royconejo/cese-pcb/README.md

Pagina oficial del proyecto: http://www.retro-ciaa.com

# RETRO-CIAA 
RETRO-CIAA es una expansión para la placa EDU-CIAA-NXP desarrollada por Santiago Germino (royconejo) como trabajo final de la carrera de especializacion en sistemas embebidos de la FI-UBA.

Esta expansión permite sumar nuevas posibilidades a la placa original:

  - Salida de video 720p@60 Hz, resolucion lógica de 256×144 pixels.
  - Audio stereo en 16 bits, 44100 kHz.
  - Conectividad WiFi / Bluetooth.
  - Entrada para dos joysticks de “family game“.

Todo esto sin bloquear la conectividad a los puertos preexistentes.

El proyecto se divide en dos; el hardware (placa de expansión con sus puertos) y un nuevo firmware. Todo sera de diseño y código abierto. El objetivo es aportar herramientas para la enseñanza de computación gráfica o desarrollo de videojuegos.
