royconejo/cese-pcb/retro-ciaa.kicad_pcb

## KiCad design retro-ciaa.kicad_pcb (2018-10-18)

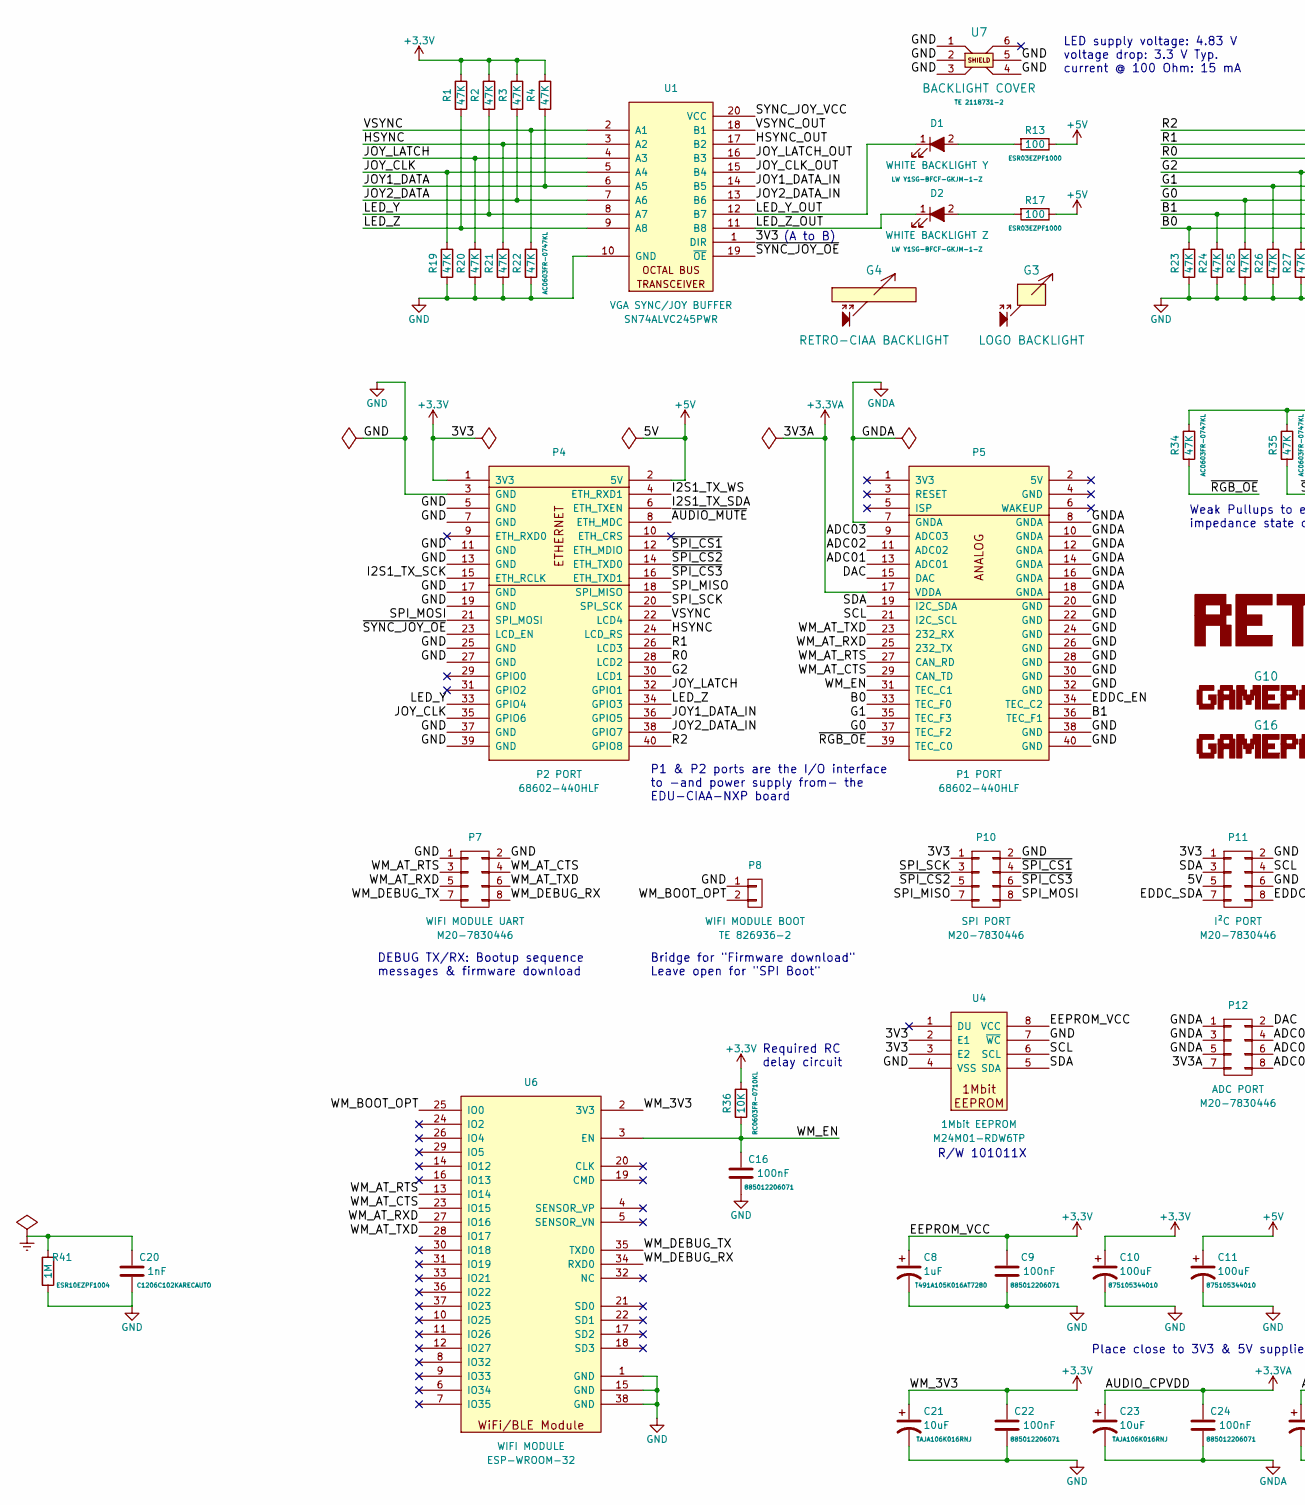
[picture p9: schematic retro-ciaa.sch, part in row 1, column 1]

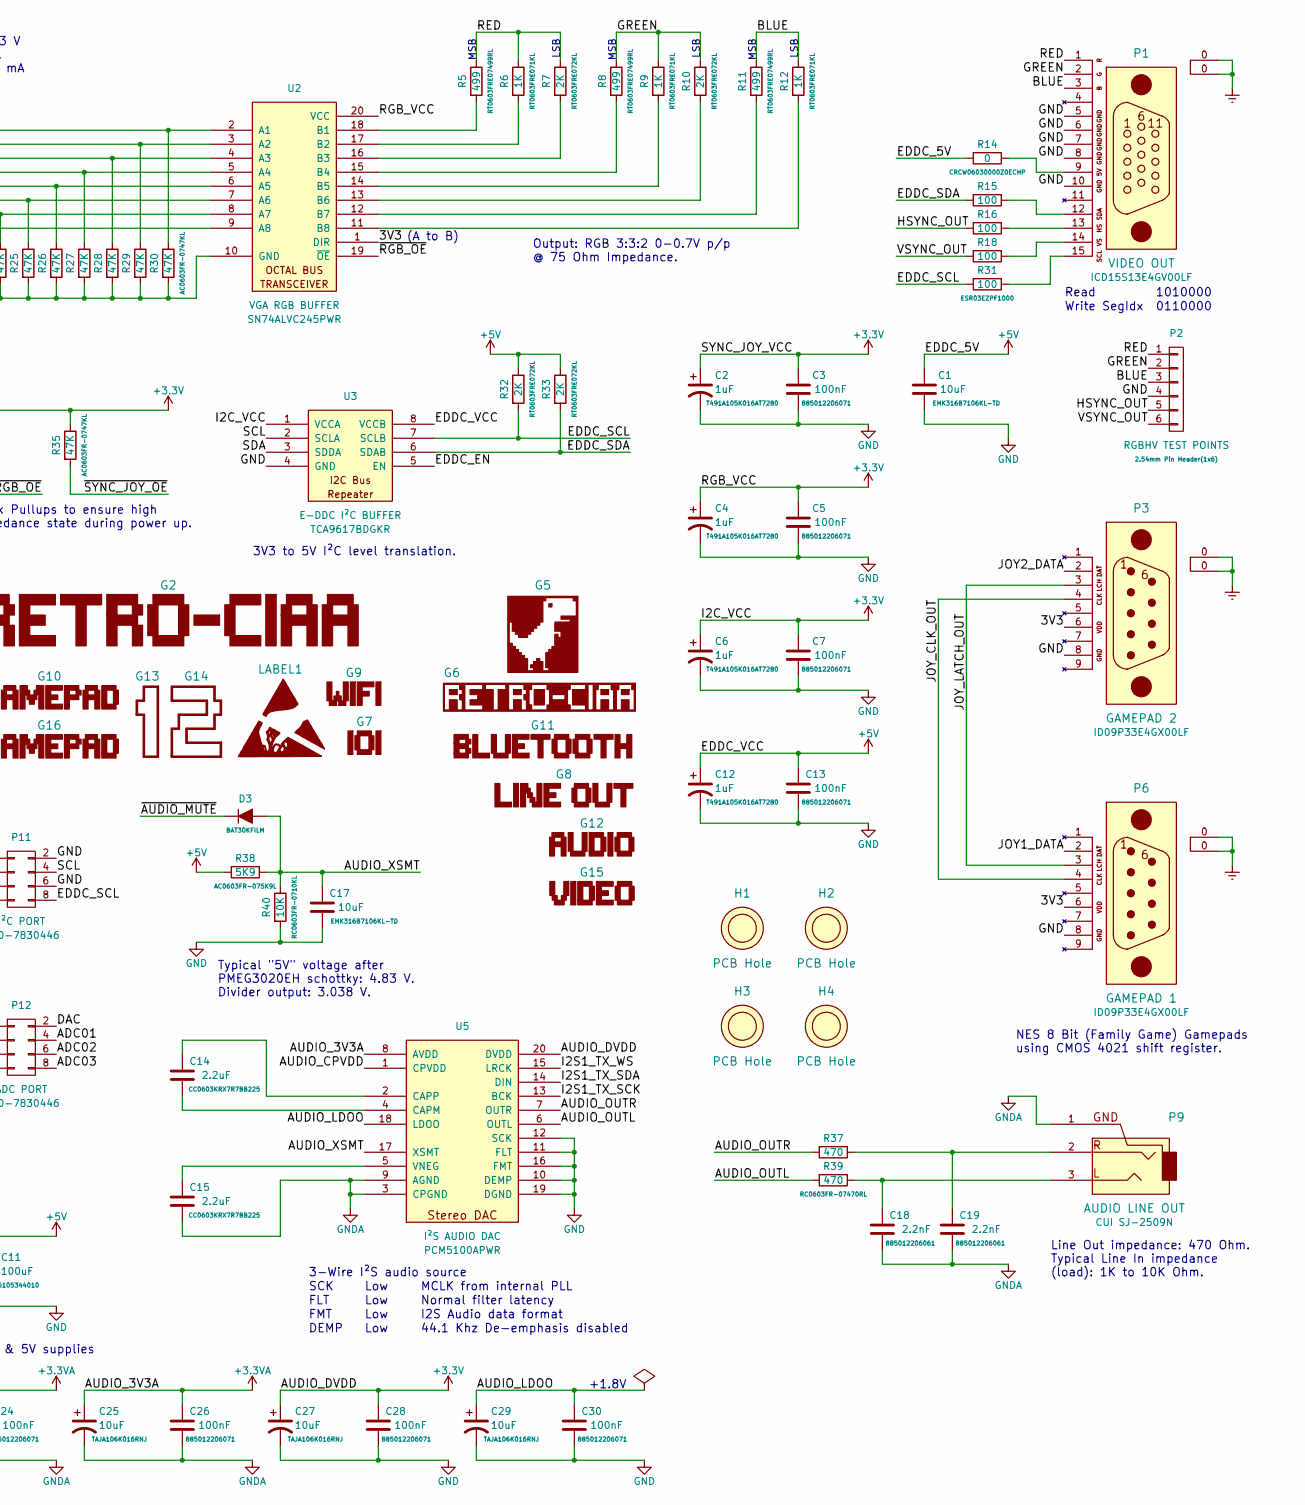
[picture p10: schematic retro-ciaa.sch, part in row 1, column 2]

Parts:
C1, C17: 10uF; C_1206
C2, C4, C6, C8, C12: 1uF; CP_Tantalum_Case-A_EIA-3216-18_Reflow
C3, C5, C7, C9, C13, C16, C22, C24, C26, C28, C30: 100nF; C_0603
C10, C11: 100uF; CP_Elec_6.3x5.8
C14, C15: 2.2uF; C_0603
C18, C19: 2.2nF; C_0603
C20: 1nF; C_1206
C21, C23, C25, C27, C29: 10uF; CP_Tantalum_Case-A_EIA-3216-18_Reflow
D1: WHITE BACKLIGHT Y; LED_LW_Y1SG
D2: WHITE BACKLIGHT Z; LED_LW_Y1SG
D3: BAT30; D_SOD-523
G2: RETROCIAA_LOGO
G3: LOGO BACKLIGHT; TREX_LOGO_BACK
G4: RETRO-CIAA BACKLIGHT; RETROCIAA_LOGO_BACK
G5: LOGO_FRONT; TREX_LOGO_FRONT
G6: RETROCIAA_LOGO_FRONT
G7: RETROCIAA_VIDEO_CONN
G8: RETROCIAA_LINEOUT
G9: RETROCIAA_WIFI
G10, G16: RETROCIAA_GAMEPAD
G11: RETROCIAA_BLUETOOTH
G12: RETROCIAA_AUDIO
G13: RETROCIAA_1
G14: RETROCIAA_2
G15: RETROCIAA_VIDEO
H1, H2, H3, H4: PCB Hole; MountingHole_3.7mm_Pad_Via
LABEL1: ESD_LOGO_15; ESD_Sign_12
P1: VIDEO OUT; DSUB-15-HD_Female_Horizontal_Pitch2.29x1.98mm_EdgePinOffset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
P2: RGBHV TEST POINTS; Pin_Header_Straight_1x06_Pitch2.54mm
P3: GAMEPAD 2; DSUB-9_Male_Horizontal_Pitch2.77x2.84mm_EdgePinOffset7.70mm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
P4: P2 PORT; Pin_Header_Back_2x20_Pitch2.54mm
P5: P1 PORT; Pin_Header_Back_2x20_Pitch2.54mm
P6: GAMEPAD 1; DSUB-9_Male_Horizontal_Pitch2.77x2.84mm_EdgePinOffset7.70mm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
P7: WIFI MODULE UART; Pin_Header_Straight_2x04_Pitch2.54mm
P8: WIFI MODULE BOOT; Pin_Header_Straight_1x02_Pitch2.54mm
P9: AUDIO LINE OUT; CUI_SJ-2509N
P10: SPI PORT; Pin_Header_Straight_2x04_Pitch2.54mm
P11: I²C PORT; Pin_Header_Straight_2x04_Pitch2.54mm
P12: ADC PORT; Pin_Header_Straight_2x04_Pitch2.54mm
R1, R2, R3, R4, R19, R20, R21, R22, R23, R24, R25, R26, R27, R28, R29, R30, R34, R35: 47K; R_0603
R5, R8, R11: 499; R_0603
R6, R9, R12: 1K; R_0603
R7, R10, R32, R33: 2K; R_0603
R13, R15, R16, R17, R18, R31: 100; R_0603
R14: 0; R_0603
R36, R40: 10K; R_0603
R37, R39: 470; R_0603
R38: 5K9; R_0603
R41: 1M; R_0805
U1: VGA SYNC/JOY BUFFER; TSSOP-20_4.4x6.5mm_Pitch0.65mm
U2: VGA RGB BUFFER; TSSOP-20_4.4x6.5mm_Pitch0.65mm
U3: E-DDC I²C BUFFER; VSSOP-8_3.0x3.0mm_Pitch0.65mm
U4: 1Mbit EEPROM; TSSOP-8_4.4x3mm_Pitch0.65mm
U5: I²S AUDIO DAC; TSSOP-20_4.4x6.5mm_Pitch0.65mm
U6: WIFI MODULE; ESP-WROOM-32
U7: BACKLIGHT COVER; TE_SHIELD_2118731-2

Connections:
+3.3VA: C23.1, C24.2, C25.1, C26.2, P5.17 (VDDA), P12.7, U5.1 (CPVDD), U5.8 (AVDD)
+3V3: C2.1, C3.2, C4.1, C5.2, C6.1, C7.2, C8.1, C9.2, C10.1, C21.1, C22.2, C27.1, C28.2, P3.6, P4.1 (3V3), P6.6, P10.1, P11.1, R1.1, R2.1, R3.1, R4.1, R34.1, R35.1, R36.1, U1.1 (DIR), U1.20 (VCC), U2.1 (DIR), U2.20 (VCC), U3.1 (VCCA), U4.2 (E1), U4.3 (E2), U4.8 (VCC), U5.20 (DVDD), U6.2 (3V3)
+5V: C1.2, C11.1, C12.1, C13.2, P4.2 (5V), P11.5, R13.1, R14.2, R17.1, R32.1, R33.1, R38.2, U3.8 (VCCB)
/ADC01: P5.13 (ADC01), P12.4
/ADC02: P5.11 (ADC02), P12.6
/ADC03: P5.9 (ADC03), P12.8
/AUDIO_LDOO: C29.1, C30.2, U5.18 (LDOO)
/AUDIO_OUTL: R39.2, U5.6 (OUTL)
/AUDIO_OUTR: R37.2, U5.7 (OUTR)
/AUDIO_XSMT: C17.2, D3.2 (A), R38.1, R40.1, U5.17 (XSMT)
/B0: P5.33 (TEC_F0), R23.1, U2.9 (A8)
/B1: P5.36 (TEC_F1), R24.1, U2.8 (A7)
/BLUE: P1.3, P2.3, R11.1, R12.1
/DAC: P5.15 (DAC), P12.2
/EDDC_EN: P5.34 (TEC_C2), U3.5 (EN)
/EDDC_SCL: P11.8, R31.2, R32.2, U3.7 (SCLB)
/EDDC_SDA: P11.7, R15.2, R33.2, U3.6 (SDAB)
/G0: P5.37 (TEC_F2), R25.1, U2.7 (A6)
/G1: P5.35 (TEC_F3), R26.1, U2.6 (A5)
/G2: P4.30 (LCD1), R27.1, U2.5 (A4)
/GREEN: P1.2, P2.2, R8.1, R9.1, R10.1
/HSYNC: P4.24 (LCD_RS), R21.1, U1.3 (A2)
/HSYNC_OUT: P2.5, R16.2, U1.17 (B2)
/I2S1_TX_SCK: P4.15 (ETH_RCLK), U5.13 (BCK)
/I2S1_TX_SDA: P4.6 (ETH_TXEN), U5.14 (DIN)
/I2S1_TX_WS: P4.4 (ETH_RXD1), U5.15 (LRCK)
/JOY1_DATA: P6.2, R4.2, U1.6 (A5)
/JOY1_DATA_IN: P4.36 (GPIO5), U1.14 (B5)
/JOY2_DATA: P3.2, R3.2, U1.7 (A6)
/JOY2_DATA_IN: P4.38 (GPIO7), U1.13 (B6)
/JOY_CLK: P4.35 (GPIO6), R19.1, U1.5 (A4)
/JOY_CLK_OUT: P3.4, P6.4, U1.15 (B4)
/JOY_LATCH: P4.32 (GPIO1), R20.1, U1.4 (A3)
/JOY_LATCH_OUT: P3.3, P6.3, U1.16 (B3)
/LED_Y: P4.33 (GPIO4), R2.2, U1.8 (A7)
/LED_Y_OUT: D1.1 (K), U1.12 (B7)
/LED_Z: P4.34 (GPIO3), R1.2, U1.9 (A8)
/LED_Z_OUT: D2.1 (K), U1.11 (B8)
/R0: P4.28 (LCD2), R28.1, U2.4 (A3)
/R1: P4.26 (LCD3), R29.1, U2.3 (A2)
/R2: P4.40 (GPIO8), R30.1, U2.2 (A1)
/RED: P1.1, P2.1, R5.1, R6.1, R7.1
/SCL: P5.21 (I2C_SCL), P11.4, U3.2 (SCLA), U4.6 (SCL)
/SDA: P5.19 (I2C_SDA), P11.3, U3.3 (SDDA), U4.5 (SDA)
/SPI_MISO: P4.18 (SPI_MISO), P10.7
/SPI_MOSI: P4.21 (SPI_MOSI), P10.8
/SPI_SCK: P4.20 (SPI_SCK), P10.3
/VSYNC: P4.22 (LCD4), R22.1, U1.2 (A1)
/VSYNC_OUT: P2.6, R18.2, U1.18 (B1)
/WM_AT_CTS: P5.29 (CAN_TD), P7.4, U6.23 (IO15)
/WM_AT_RTS: P5.27 (CAN_RD), P7.3, U6.13 (IO14)
/WM_AT_RXD: P5.25 (232_TX), P7.5, U6.27 (IO16)
/WM_AT_TXD: P5.23 (232_RX), P7.6, U6.28 (IO17)
/WM_BOOT_OPT: P8.2, U6.25 (IO0)
/WM_DEBUG_RX: P7.8, U6.34 (RXD0)
/WM_DEBUG_TX: P7.7, U6.35 (TXD0)
/WM_EN: C16.2, P5.31 (TEC_C1), R36.2, U6.3 (EN)
/~AUDIO_MUTE: D3.1 (K), P4.8 (ETH_MDC)
/~RGB_OE: P5.39 (TEC_C0), R34.2, U2.19 (~OE)
/~SPI_CS1: P4.12 (ETH_MDIO), P10.4
/~SPI_CS2: P4.14 (ETH_TXD0), P10.5
/~SPI_CS3: P4.16 (ETH_TXD1), P10.6
/~SYNC_JOY_OE: P4.23 (LCD_EN), R35.2, U1.19 (~OE)
Earth: C20.2, P1.0, P3.0, P6.0, R41.1
GND: C1.1, C2.2, C3.1, C4.2, C5.1, C6.2, C7.1, C8.2, C9.1, C10.2, C11.2, C12.2, C13.1, C16.1, C17.1, C20.1, C21.2, C22.1, C27.2, C28.1, C29.2, C30.1, P1.5, P1.6, P1.7, P1.8, P1.10, P2.4, P3.8, P4.3 (GND), P4.5 (GND), P4.7 (GND), P4.11 (GND), P4.13 (GND), P4.17 (GND), P4.19 (GND), P4.25 (GND), P4.27 (GND), P4.37 (GND), P4.39 (GND), P5.20 (GND), P5.22 (GND), P5.24 (GND), P5.26 (GND), P5.28 (GND), P5.30 (GND), P5.32 (GND), P5.38 (GND), P5.40 (GND), P6.8, P7.1, P7.2, P8.1, P10.2, P11.2, P11.6, R19.2, R20.2, R21.2, R22.2, R23.2, R24.2, R25.2, R26.2, R27.2, R28.2, R29.2, R30.2, R40.2, R41.2, U1.10 (GND), U2.10 (GND), U3.4 (GND), U4.4 (VSS), U4.7 (~WC), U5.10 (DEMP), U5.11 (FLT), U5.12 (SCK), U5.16 (FMT), U5.19 (DGND), U6.1 (GND), U6.15 (GND), U6.38 (GND), U7.1, U7.2, U7.3, U7.4, U7.5
GNDA: C15.1, C18.1, C19.1, C23.2, C24.1, C25.2, C26.1, P5.7 (GNDA), P5.8 (GNDA), P5.10 (GNDA), P5.12 (GNDA), P5.14 (GNDA), P5.16 (GNDA), P5.18 (GNDA), P9.1, P12.1, P12.3, P12.5, U5.3 (CPGND), U5.9 (AGND)
unnamed: C14.1, U5.4 (CAPM)
unnamed: C14.2, U5.2 (CAPP)
unnamed: C15.2, U5.5 (VNEG)
unnamed: C18.2, P9.3, R39.1
unnamed: C19.2, P9.2, R37.1
unnamed: D1.2 (A), R13.2
unnamed: D2.2 (A), R17.2
unnamed: P1.9, R14.1
unnamed: P1.12, R15.1
unnamed: P1.13, R16.1
unnamed: P1.14, R18.1
unnamed: P1.15, R31.1
unnamed: R5.2, U2.18 (B1)
unnamed: R6.2, U2.17 (B2)
unnamed: R7.2, U2.16 (B3)
unnamed: R8.2, U2.15 (B4)
unnamed: R9.2, U2.14 (B5)
unnamed: R10.2, U2.13 (B6)
unnamed: R11.2, U2.12 (B7)
unnamed: R12.2, U2.11 (B8)

Notes on the sheet:
MSB
LSB
Output: RGB 3:3:2 0-0.7V p/p @ 75 Ohm Impedance.
(A to B)
3V3 to 5V I²C level translation.
Weak Pullups to ensure high impedance state during power up.
NES 8 Bit (Family Game) Gamepads using CMOS 4021 shift register.
Line Out impedance: 470 Ohm. Typical Line In impedance (load): 1K to 10K Ohm.
FLT
Low
Normal filter latency
FMT
I2S Audio data format
3-Wire I²S audio source
SCK
MCLK from internal PLL
DEMP
44.1 Khz De-emphasis disabled
+1.8V
Typical "5V" voltage after PMEG3020EH schottky: 4.83 V. Divider output: 3.038 V.
Bridge for "Firmware download" Leave open for "SPI Boot"
DEBUG TX/RX: Bootup sequence messages & firmware download
R/W 101011X
1010000
0110000
Write SegIdx
Read
Place close to 3V3 & 5V supplies
Required RC delay circuit
P1 & P2 ports are the I/O interface to -and power supply from- the EDU-CIAA-NXP board
LED supply voltage: 4.83 V voltage drop: 3.3 V Typ. current @ 100 Ohm: 15 mA

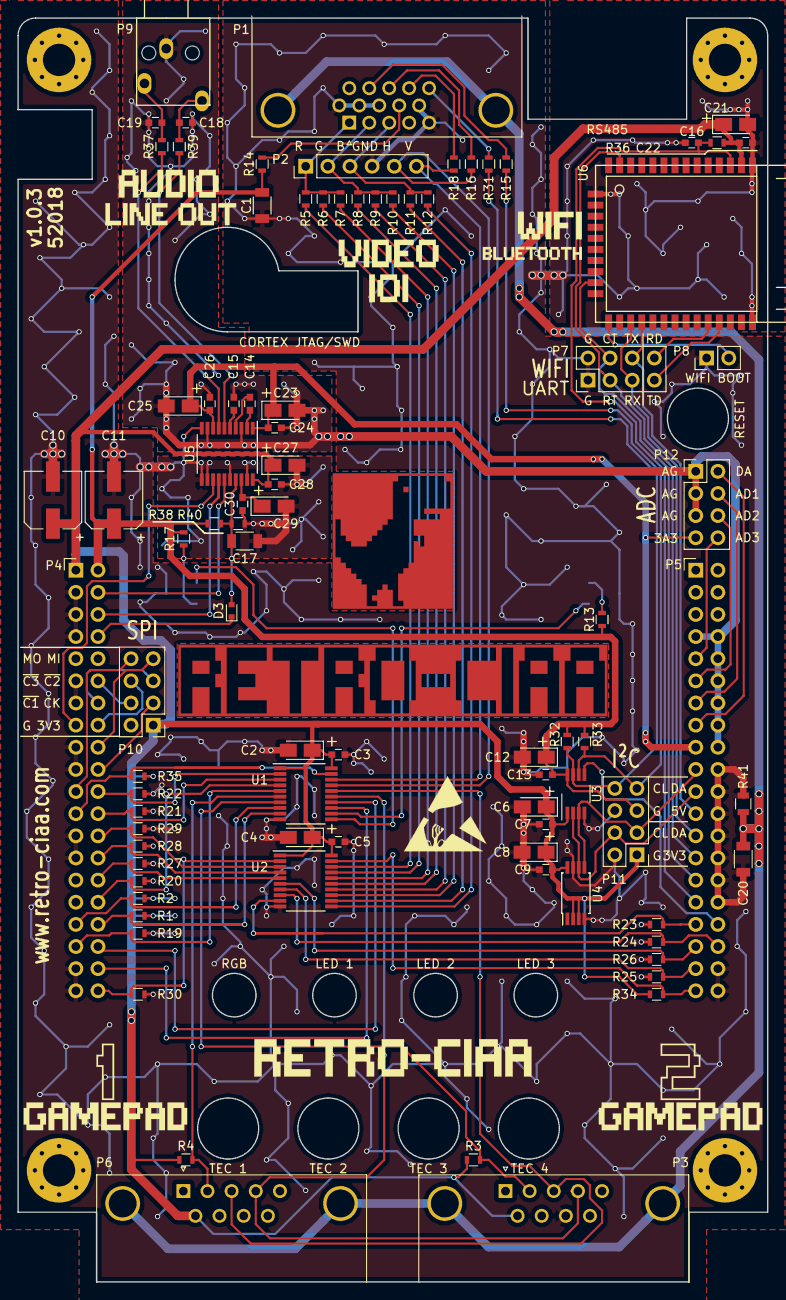
[picture p11: board retro-ciaa.kicad_pcb from above]

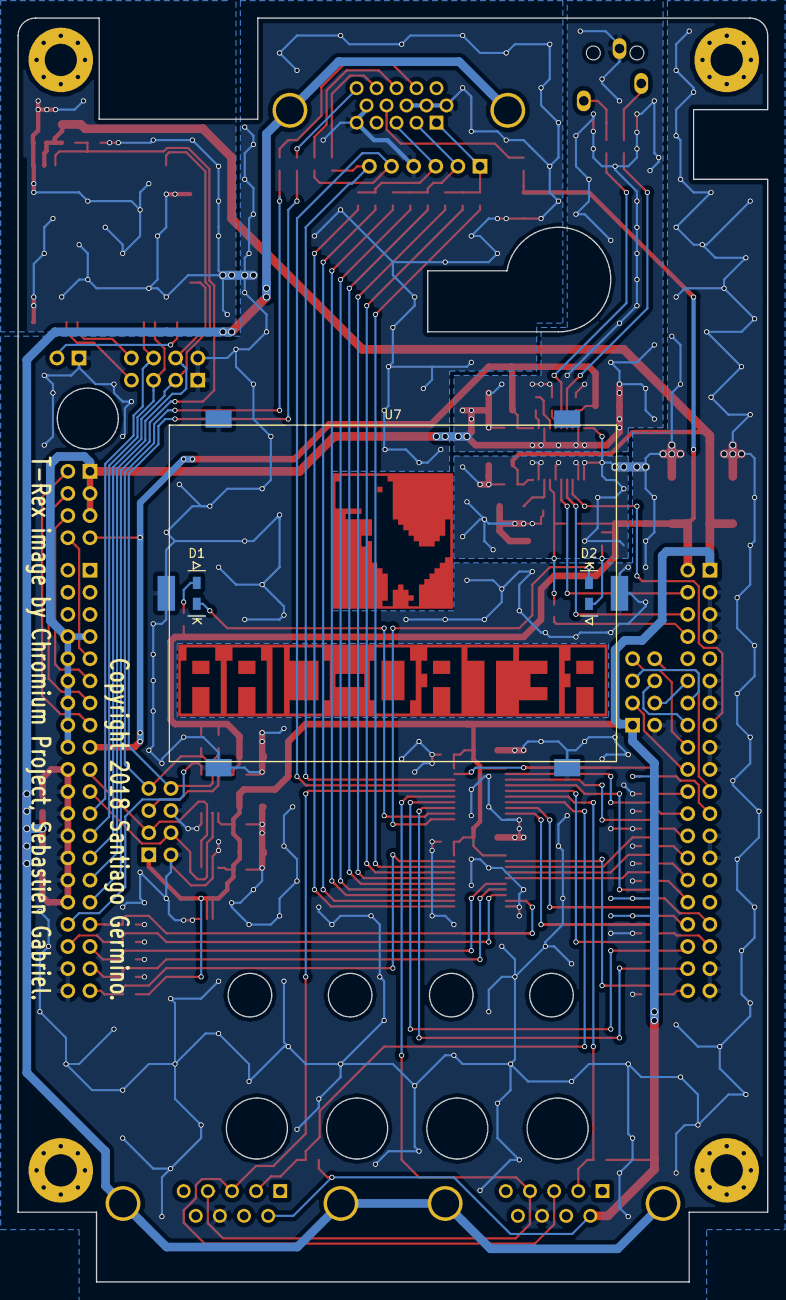
[picture p12: board retro-ciaa.kicad_pcb from below]

Board: 2 copper layers, 86.0 x 145.0 mm, 113 parts (5 on the bottom side), 86 nets.
