royconejo/cese-pcb/(commit log)

2018-10-18 Se inicia trabajo de esquematico a hojas jerarquicas A4 y nuevo layout de componentes
    [_saved_buffers.sch, buffers.sch, retro-ciaa.kicad_pcb, retro-ciaa.sch]
2018-10-19 Esquematico A3 terminado
    [retro-ciaa.sch]
2018-10-19 Esquematico A3 terminado, 1.0.1
    [retro-ciaa.sch]
2018-10-19 Esquematico hierarchical sheets A4 terminado, 1.1.1
    [audio.sch, educiaa.sch, joyled.sch, labels.sch, retro-ciaa.sch, storage.sch, video.sch, wifi.sch]
2018-10-19 Detalles menores (reordenamiento de labels, correccion de titulo, etc
    [joyled.sch, labels.sch, retro-ciaa.sch]
2018-10-19 Cambios menores
    [audio.sch, educiaa.sch, joyled.sch, labels.sch, retro-ciaa.sch, storage.sch, video.sch, wifi.sch]
2018-10-20 Nuevo layout, mejoras y modificaciones del revisor
    [audio.sch, educiaa.sch, joyled.sch, labels.sch, retro-ciaa.sch, storage.sch, video.sch, wifi.sch]
2018-10-20 Borrado de archivos de backup, gitignore para no agregarlos nuevamente
2018-10-20 Modificacion para clarificar uso de multiparte en U1 y U2
    [audio.sch, educiaa.sch, joyled.sch, labels.sch, storage.sch, video.sch, wifi.sch]
2018-10-20 Se movio comentario de senial de video
    [video.sch]
2018-10-26 Aclaracion menor sobre uso de U1 en diferentes sheets
    [joyled.sch, video.sch]
2018-11-21 Se agrego indice en pagina 1. Union de islas de componentes con cables
    [audio.sch, educiaa.sch, joyled.sch, labels.sch, retro-ciaa.sch, storage.sch, video.sch, wifi.sch]
2018-11-21 Limpieza de etiquetas de alimentacion
    [audio.sch, educiaa.sch, joyled.sch, storage.sch, wifi.sch]
2018-11-21 Cambio menor en el componente indice
    [retro-ciaa.sch]
2018-12-28 added LICENCE
    [audio.sch, educiaa.sch, joyled.sch, labels.sch, retro-ciaa.sch, storage.sch, video.sch, wifi.sch]
