royconejo/cese-pcb/(notices)

Notices in the files:
video.sch:
Copyright 2018 Santiago Germino (see LICENSE)
